niko666-donk666/industrial-gateway/docs/实验记录索引.md

# 实验记录索引

本索引汇总已完成真实硬件验证的实验，用于追溯版本、复现流程和核对原始证据。

| 版本 | 实验 | 状态 | 主要证据 |
|---|---|---|---|
| v0.1 | [STM32与OLED启动](实验流程_v0.1_STM32_OLED启动.md) | **已通过** | OLED正常初始化与显示 |
| v0.2 | [STM32与ESP32双向ACK](实验流程_v0.2_STM32_ESP32双向ACK.md) | **已通过** | 心跳帧与ACK双向通信 |
| v0.3 | [序号确认与超时重传](实验流程_v0.3_序号确认与超时重传.md) | **已通过** | 连续序号、断线重传与恢复 |
| v0.9 | [Modbus RTU端到端读取成功](实验记录_v0.9_Modbus_RTU端到端读取成功.md) | **已通过** | `Rx`持续增长、请求/响应配对、OLED显示`9/9 OK`与1234/5678 |
| v1.0 | [AHT20、INA219与5V风扇负载测量](实验记录_v1.0_AHT20_INA219_5V风扇负载测量.md) | **已通过** | 5.0V、0.13A、0.65W、CV模式，连续运行约10分钟 |
| v1.1 | [MQTT启动时序](问题记录_v1.1_MQTT启动时序.md) | **已通过实机验证** | 获得IP后启动MQTT并成功连接Broker |
| v1.2 | [Qt上位机端到端监控](实验记录_v1.2_Qt上位机端到端监控.md) | **已通过** | 传感器、5V风扇、Modbus 1234/5678、UART ACK及MQTT日志同时正常 |
| v1.3 | [STM32—ESP32 ACK回传断线故障注入](实验记录_v1.3_STM32_ESP32_ACK回传断线故障注入.md) | **已通过** | 回传线断开约1分钟；同一序号约500ms重传；OLED离线；复线后每秒递增恢复 |
| v1.4 | [Modbus接收链路断线与自动恢复](实验记录_v1.4_Modbus接收链路断线与自动恢复.md) | **已通过** | 从站仍收发报文；STM32判定离线且其他任务继续；复线后自动恢复1234/5678 |
| v1.5 | [Wi-Fi/MQTT断线与自动重连](实验记录_v1.5_WiFi_MQTT断线与自动重连.md) | **已通过** | 断网约3分钟；本地任务继续运行；网络恢复后MQTT自动恢复发布 |

## 已验证端到端链路

```text
AHT20 / INA219 / Modbus RTU从站
                 |
                 v
          STM32 + FreeRTOS
            |          |
            v          v
          OLED    UART心跳/遥测
                       |
                       v
                     ESP32 ── Wi-Fi/MQTT ── Broker
                       |
                       └── USB串口 ── Qt上位机
```

索引中每项结论均对应独立实验记录、原始截图和明确判定依据。
