niko666-donk666/industrial-gateway/docs/问题记录_v1.1_工程迁移缓存与MQTT启动时序.md

# 问题记录 v1.1：工程迁移缓存与MQTT启动时序

## 记录日期

2026-08-08

## 问题背景

ESP32正式网关工程从旧目录 `C:\D盘资料\industrial_gateway` 移动到新目录 `C:\industrial_gateway` 后，在VS Code中执行总命令：

```text
ESP-IDF: Build, Flash and Monitor your Device
```

先后暴露出两个相互独立的问题：旧CMake构建缓存仍引用原目录，以及MQTT客户端在Wi-Fi获得IP地址前提前启动。

## 问题一：移动工程后构建失败

### 现象

构建进行到生成链接脚本时失败：

```text
[911/915] Generating ld/sections.ld
FAILED
系统找不到指定的路径
```

日志中的生成路径仍出现旧工程目录，而VS Code实际已经打开新目录。

### 原因

`esp32_gateway/build/CMakeCache.txt` 保存了大量绝对路径。直接移动整个工程时也复制了旧的 `build` 目录，因此CMake继续访问：

```text
C:\D盘资料\industrial_gateway\esp32_gateway
```

这不是ESP32源码错误，而是不可跨目录复用的构建缓存。

### 处理

将旧缓存保留为备份：

```text
C:\industrial_gateway\esp32_gateway\build-old-path-cache-20260808-194809
```

随后由ESP-IDF在新路径重新生成 `build`。源码、`sdkconfig`和VS Code工程设置均未删除。

### 验证

重新构建后成功生成：

```text
C:/industrial_gateway/esp32_gateway/build/esp32_gateway.bin
```

最终构建返回成功，证明旧路径缓存问题已经排除。

## 问题二：MQTT首次连接早于Wi-Fi联网

### 现象

正式固件成功启动，UART初始化正常，但MQTT首先报告DNS和传输连接失败：

```text
Gateway UART ready: RX=GPIO16, TX=GPIO17, 115200 8N1
esp-tls: couldn't get hostname for broker.emqx.io
mqtt_client: Error transport connect
MQTT error
MQTT disconnected
```

数秒后Wi-Fi才成功获取地址：

```text
Wi-Fi connected, IP=192.168.3.123
```

### 原因

原程序在 `app_main()` 中依次调用 `InitWifi()` 和 `InitMqtt()`。`InitWifi()`只启动异步联网流程，并不会等待DHCP完成；紧接着启动MQTT时，设备尚无IP和可用DNS，因此第一次连接必然可能失败。

### 修复方案

1. `InitMqtt()`只创建客户端并注册事件，不立即启动连接；
2. 收到 `IP_EVENT_STA_GOT_IP` 后再调用 `esp_mqtt_client_start()`；
3. 使用 `s_mqtt_started` 防止重复启动客户端；
4. 保留ESP-MQTT自身的断线自动重连机制；
5. 未修改STM32串口、Modbus、传感器数据格式、MQTT主题和QoS配置。

修复后的预期日志顺序为：

```text
MQTT client initialized; waiting for Wi-Fi IP address
Wi-Fi connected, IP=...
MQTT client started after Wi-Fi obtained an IP address
MQTT connected
```

## 构建验证结果

修改后执行独立构建验证，以下步骤全部成功：

```text
Building C object ... app_main.c.obj
Generating ld/sections.ld
Linking CXX executable esp32_gateway.elf
Successfully created esp32 image
Generated C:/industrial_gateway/esp32_gateway/build/esp32_gateway.bin
```

固件大小为 `0xdc7b0` 字节，应用分区剩余约14%。随后使用VS Code总命令完成重新烧录与串口监视，进入正式的 `esp32_gateway` 固件。

## 实机验证结果

修复后的启动日志严格符合设计顺序：

```text
I (783) gateway: MQTT client initialized; waiting for Wi-Fi IP address
I (5313) gateway: Wi-Fi connected, IP=192.168.3.123
I (5313) gateway: MQTT client started after Wi-Fi obtained an IP address
I (5943) gateway: MQTT connected
```

本次结果证明：

1. MQTT初始化阶段不再立即访问DNS；
2. ESP32确认获得有效IP后才启动MQTT后台任务；
3. 从MQTT启动到连接Broker约用630毫秒；
4. 修复后的启动过程中未再出现 `couldn't get hostname`、`Error transport connect` 和首次 `MQTT error`；
5. Wi-Fi首次认证未成功时仍能自动重连，最终连接到路由器并获得固定局域网地址 `192.168.3.123`。

因此，MQTT启动时序修复已通过真实ESP32烧录与联网验证。

## 原始证据

完整启动日志保存在：

```text
assets/v1.1-esp32-build-mqtt-log.txt
```

## 后续复现规则

工程目录发生移动或改名后：

1. 不复用原来的 `build` 目录；
2. 保留源码、`sdkconfig`和文档；
3. 删除或重命名旧 `build` 后执行总命令重新构建；
4. 烧录前断开Qt上位机及其他串口监视器，避免COM端口被占用；
5. 以“先获得IP、再启动MQTT”作为联网状态机的固定约束。

## 结论

本次故障包含“构建环境缓存”和“运行时网络时序”两个层面。旧缓存问题已通过全新构建目录解决，MQTT时序问题已完成代码修复，并通过编译、烧录、Wi-Fi联网及MQTT Broker连接的完整实机验证。
