niko666-donk666/industrial-gateway/docs/assets/v0.6-esp32-mqtt-publish-monitor.png

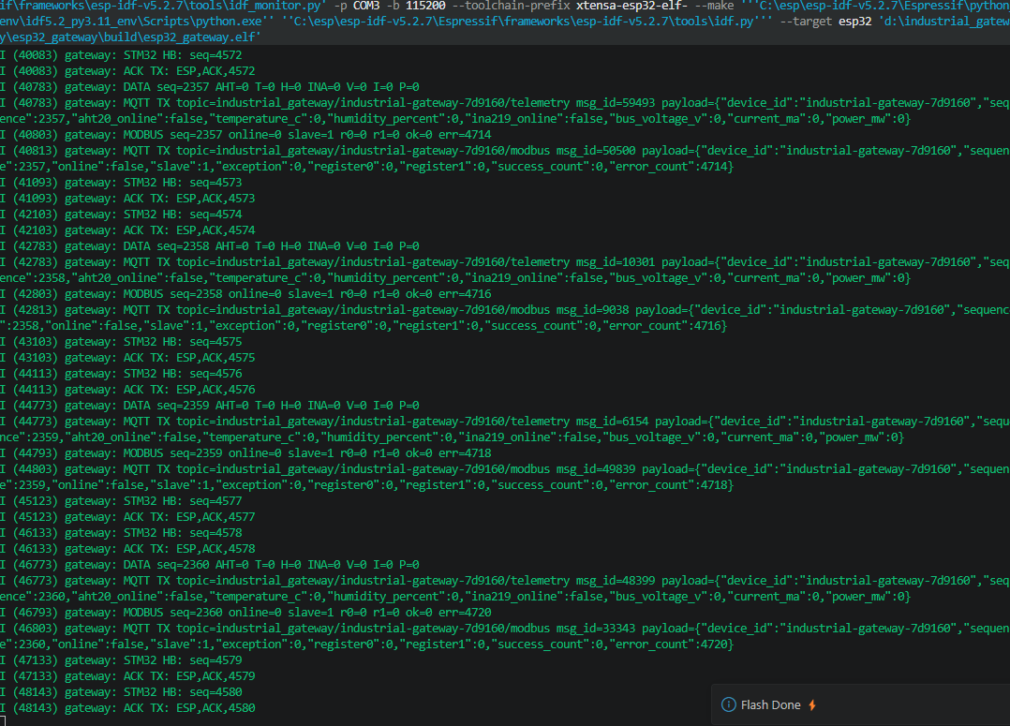
docs/assets/v0.6-esp32-mqtt-publish-monitor.png
