niko666-donk666/industrial-gateway/docs/assets/v0.6-mqttx-web-receive.png

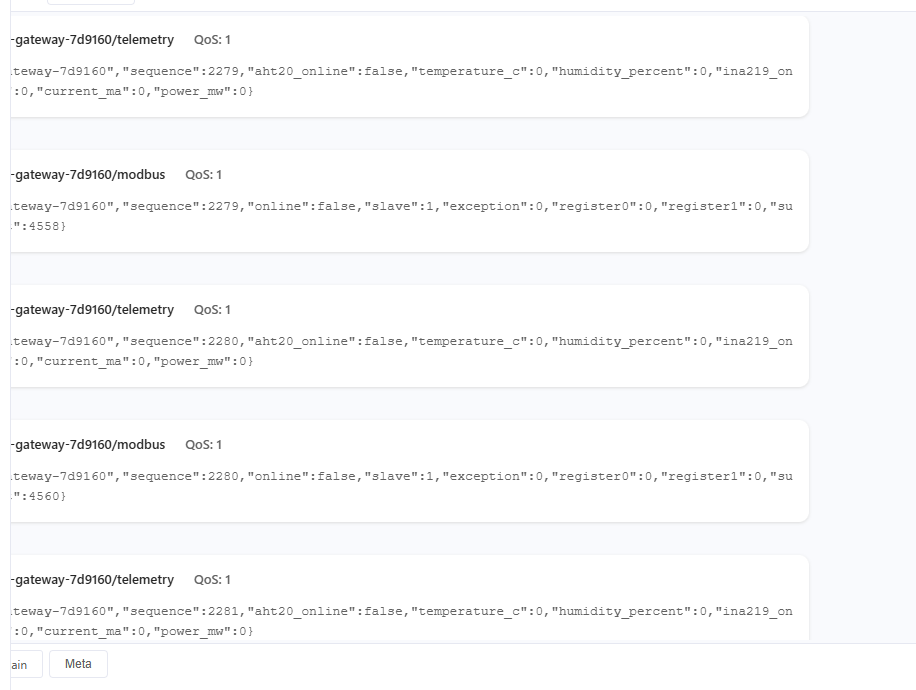
docs/assets/v0.6-mqttx-web-receive.png
