niko666-donk666/industrial-gateway/hardware/BOM_v0.1.md

# 工业网关硬件清单

以下硬件用于本仓库记录的端到端实机验证。

| 模块 | 数量 | 项目用途 | 接口/要求 |
|---|---:|---|---|
| STM32F103C8T6最小系统板 | 1 | FreeRTOS主控、数据采集、Modbus主站与OLED显示 | 3.3V逻辑 |
| ST-Link | 1 | STM32下载与调试 | SWD |
| ESP32-WROOM-32 DevKit | 1 | Wi-Fi、MQTT及Qt上位机USB串口数据源 | ESP-IDF 5.2.7 |
| AHT20 | 1 | 环境温湿度采集 | I2C、3.3V兼容 |
| INA219 | 1 | 负载电压、电流与功率采集 | I2C、3.3V逻辑 |
| SSD1306 0.96寸OLED | 1 | 本地状态显示 | I2C |
| MAX3485/SP3485类RS485模块 | 1 | STM32侧RS485物理层 | 3.3V逻辑 |
| USB转RS485模块 | 1 | 电脑Modbus从站与RS485总线连接 | 支持9600 8N1 |
| 5V直流风扇 | 1 | INA219负载测量 | 约0.13～0.17A |
| 可调直流电源 | 1 | 为5V风扇提供独立稳压电源 | 设为5.0V并限流 |
| 830孔面包板 | 2 | 原型搭建 | 电源轨分段处需跨接 |
| 杜邦线、USB线及转接线 | 若干 | 信号、供电与共地连接 | 保证接触可靠 |
| 10µF、100µF电解电容 | 若干 | 电源缓冲与负载去耦 | 注意极性 |

## 关键选型说明

- STM32 GPIO为3.3V逻辑，RS485收发器的RO输出必须与3.3V输入安全兼容；
- STM32与ESP32分别通过USB供电，只连接UART信号线和公共GND，不互接两块开发板的3.3V或5V；
- 风扇使用独立5V电源，INA219串联在风扇正极供电路径中；
- AHT20、INA219与OLED共用STM32 I2C1总线。

详细接线、测试数值和现场照片见 `docs/实验记录_v1.0_AHT20_INA219_5V风扇负载测量.md` 与 `docs/实验记录_v0.9_Modbus_RTU端到端读取成功.md`。
