niko666-donk666/industrial-gateway/Core/Inc/main.h

#define HEARTBEAT_LED_Pin GPIO_PIN_13
#define HEARTBEAT_LED_GPIO_Port GPIOC
#define RS485_DE_Pin GPIO_PIN_1
#define RS485_DE_GPIO_Port GPIOB
