niko666-donk666/industrial-gateway/(commit log)

2026-08-09 精简公开文档内容
2026-08-09 整理项目交付文档
2026-08-10 重写项目完成态README
2026-08-10 按完成态整理开源项目文档
